lewipewi/bmi-270-board-v3/pcb/bmi270-board-v3.kicad_pcb

## KiCad design pcb/bmi270-board-v3.kicad_pcb (2026-10-18)

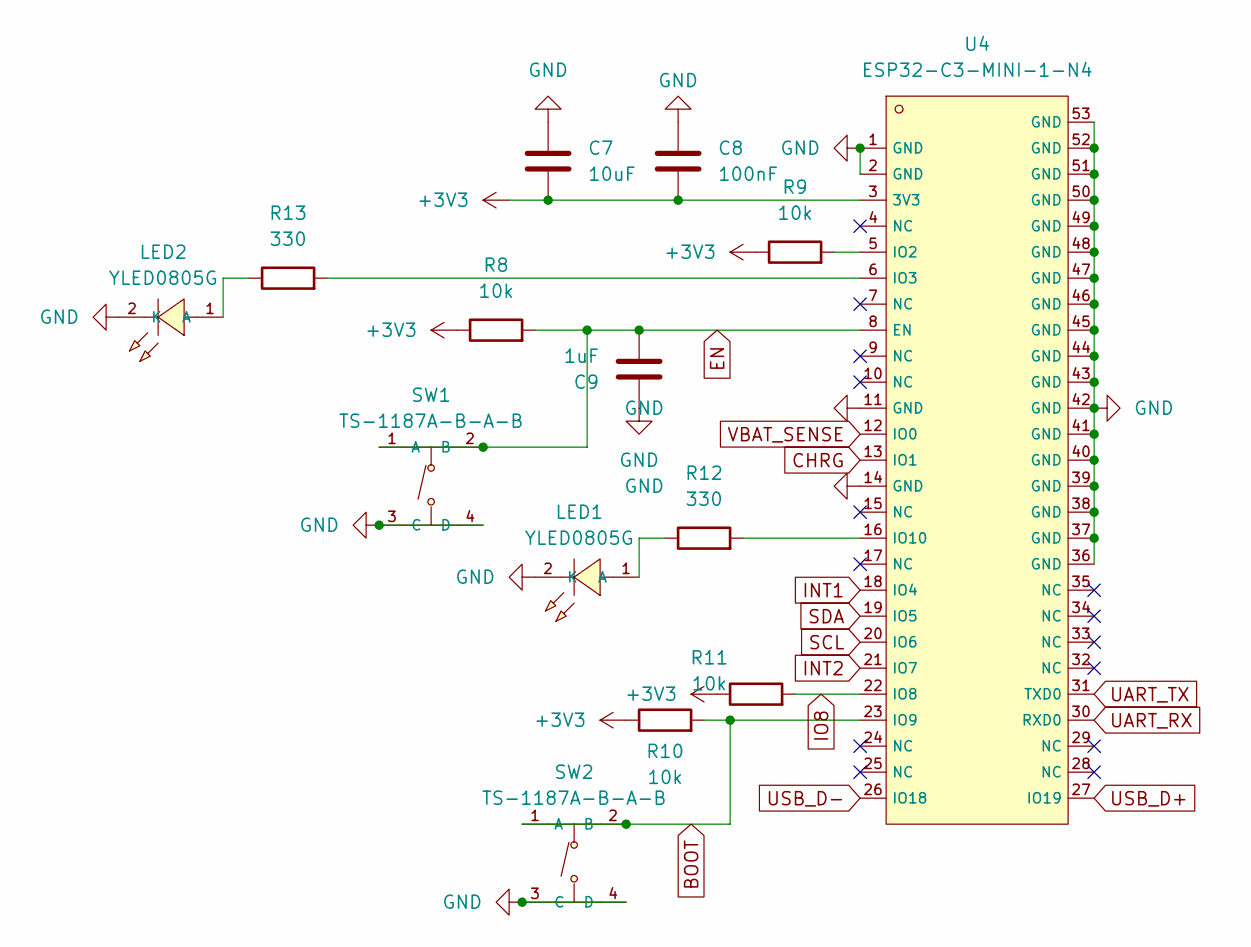
[picture p1: schematic mcu.kicad_sch]

Parts:
C7: 10uF; C_0805_2012Metric_Pad1.18x1.45mm_HandSolder
C8: 100nF; C_0603_1608Metric_Pad1.08x0.95mm_HandSolder
C9: 1uF; C_0603_1608Metric_Pad1.08x0.95mm_HandSolder
LED1, LED2: YLED0805G; C25170728_LED0805-FD-GREEN; LCSC C25170728
R8, R9, R10, R11: 10k; R_0603_1608Metric_Pad0.98x0.95mm_HandSolder
R12, R13: 330; R_0603_1608Metric_Pad0.98x0.95mm_HandSolder
SW1, SW2: TS-1187A-B-A-B; C318884_SW-SMD_4P-L5_1-W5_1-P3_70-LS6_5-TL_H1_5; LCSC C318884
U4: ESP32-C3-MINI-1-N4; C2838502_WIFIM-SMD_ESP32-C3-MINI-1; LCSC C2838502

Connections:
+3V3: C7.2, C8.2, R8.1, R9.1, R10.1, R11.1, U4.3 (3V3); also elsewhere on the board
BOOT: R10.2, SW2.1 (A), SW2.2 (B), U4.23 (IO9); also elsewhere on the board
CHRG: U4.13 (IO1); also elsewhere on the board
EN: C9.2, R8.2, SW1.1 (A), SW1.2 (B), U4.8 (EN); also elsewhere on the board
GND: C7.1, C8.1, C9.1, LED1.2 (K), LED2.2 (K), SW1.3 (C), SW1.4 (D), SW2.3 (C), SW2.4 (D), U4.1 (GND), U4.2 (GND), U4.11 (GND), U4.14 (GND), U4.36 (GND), U4.37 (GND), U4.38 (GND), U4.39 (GND), U4.40 (GND), U4.41 (GND), U4.42 (GND), U4.43 (GND), U4.44 (GND), U4.45 (GND), U4.46 (GND), U4.47 (GND), U4.48 (GND), U4.49 (GND), U4.50 (GND), U4.51 (GND), U4.52 (GND), U4.53 (GND); also elsewhere on the board
INT1: U4.18 (IO4); also elsewhere on the board
INT2: U4.21 (IO7); also elsewhere on the board
IO8: R11.2, U4.22 (IO8); also elsewhere on the board
unnamed: LED1.1 (A), R12.1
unnamed: LED2.1 (A), R13.1
unnamed: R9.2, U4.5 (IO2)
unnamed: R13.2, U4.6 (IO3)
unnamed: R12.2, U4.16 (IO10)
SCL: U4.20 (IO6); also elsewhere on the board
SDA: U4.19 (IO5); also elsewhere on the board
UART_RX: U4.30 (RXD0); also elsewhere on the board
UART_TX: U4.31 (TXD0); also elsewhere on the board
USB_D+: U4.27 (IO19); also elsewhere on the board
USB_D-: U4.26 (IO18); also elsewhere on the board
VBAT_SENSE: U4.12 (IO0); also elsewhere on the board

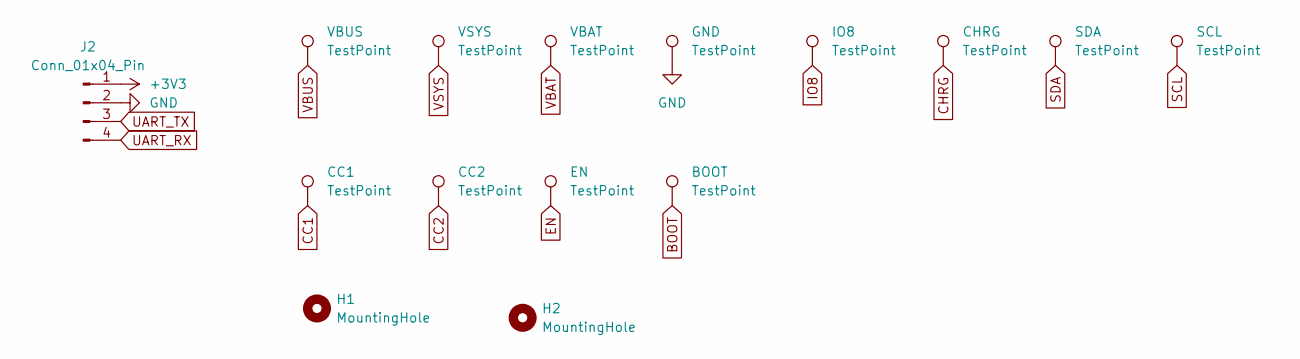
[picture p2: schematic MECHANICAL.kicad_sch]

Parts:
BOOT: TestPoint; TestPoint_Pad_D1.0mm
CC1, CC2: TestPoint; TestPoint_Pad_D1.0mm
CHRG: TestPoint; TestPoint_Pad_D1.0mm
EN: TestPoint; TestPoint_Pad_D1.0mm
GND: TestPoint; TestPoint_Pad_D1.0mm
H1, H2: MountingHole; MountingHole_2.2mm_M2
IO8: TestPoint; TestPoint_Pad_D1.0mm
J2: Conn_01x04_Pin; PinHeader_1x04_P2.54mm_Vertical
SCL: TestPoint; TestPoint_Pad_D1.0mm
SDA: TestPoint; TestPoint_Pad_D1.0mm
VBAT: TestPoint; TestPoint_Pad_D1.0mm
VBUS: TestPoint; TestPoint_Pad_D1.0mm
VSYS: TestPoint; TestPoint_Pad_D1.0mm

Connections:
+3V3: J2.1; also elsewhere on the board
BOOT: BOOT.1; also elsewhere on the board
CC1: CC1.1; also elsewhere on the board
CC2: CC2.1; also elsewhere on the board
CHRG: CHRG.1; also elsewhere on the board
EN: EN.1; also elsewhere on the board
GND: GND.1, J2.2; also elsewhere on the board
IO8: IO8.1; also elsewhere on the board
SCL: SCL.1; also elsewhere on the board
SDA: SDA.1; also elsewhere on the board
UART_RX: J2.4; also elsewhere on the board
UART_TX: J2.3; also elsewhere on the board
VBAT: VBAT.1; also elsewhere on the board
VBUS: VBUS.1; also elsewhere on the board
VSYS: VSYS.1; also elsewhere on the board

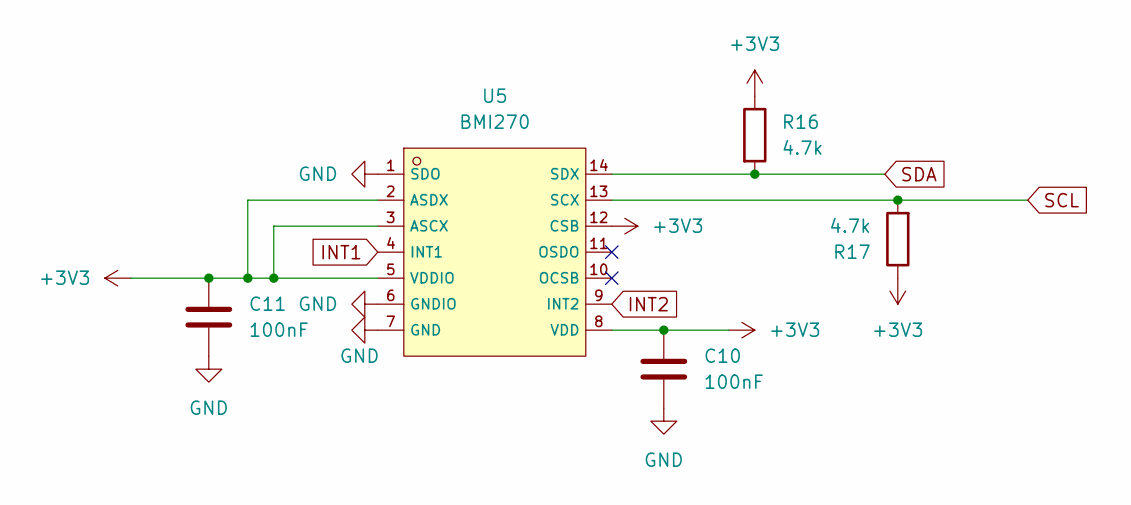
[picture p3: schematic IMU.kicad_sch]

Parts:
C10, C11: 100nF; C_0603_1608Metric_Pad1.08x0.95mm_HandSolder
R16, R17: 4.7k; R_0603_1608Metric_Pad0.98x0.95mm_HandSolder
U5: BMI270; C2836813_LGA-14_L3_0-W2_5-P0_50-BR; LCSC C2836813

Connections:
+3V3: C10.1, C11.1, R16.1, R17.1, U5.2 (ASDX), U5.3 (ASCX), U5.5 (VDDIO), U5.8 (VDD), U5.12 (CSB); also elsewhere on the board
GND: C10.2, C11.2, U5.1 (SDO), U5.6 (GNDIO), U5.7 (GND); also elsewhere on the board
INT1: U5.4 (INT1); also elsewhere on the board
INT2: U5.9 (INT2); also elsewhere on the board
SCL: R17.2, U5.13 (SCX); also elsewhere on the board
SDA: R16.2, U5.14 (SDX); also elsewhere on the board

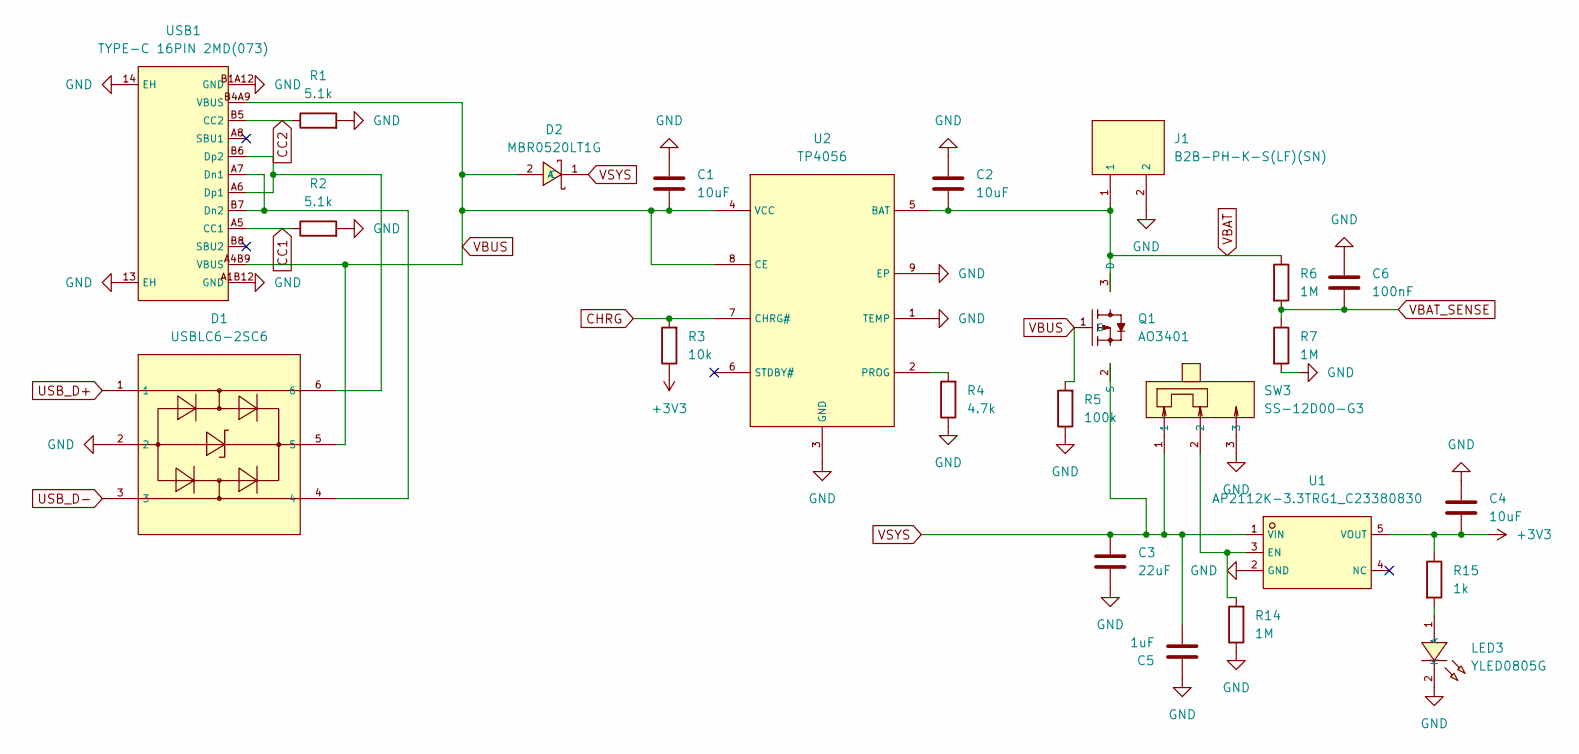
[picture p4: schematic power.kicad_sch]

Parts:
C1, C2, C4: 10uF; C_0805_2012Metric_Pad1.18x1.45mm_HandSolder
C3: 22uF; C_1206_3216Metric_Pad1.33x1.80mm_HandSolder
C5: 1uF; C_0603_1608Metric_Pad1.08x0.95mm_HandSolder
C6: 100nF; C_0603_1608Metric_Pad1.08x0.95mm_HandSolder
D1: USBLC6-2SC6; C7519_SOT-23-6_L2_9-W1_6-P0_95-LS2_8-BL; LCSC C7519
D2: MBR0520LT1G; C23848_SOD-123_L2_8-W1_8-LS3_7-RD; LCSC C23848
J1: B2B-PH-K-S(LF)(SN); C131337_CONN-TH_B2B-PH-K-S; LCSC C131337
LED3: YLED0805G; C25170728_LED0805-FD-GREEN; LCSC C25170728
Q1: AO3401; C181091_SOT-23-3_L2_9-W1_3-P1_90-LS2_4-BR; LCSC C181091
R1, R2: 5.1k; R_0603_1608Metric_Pad0.98x0.95mm_HandSolder
R3: 10k; R_0603_1608Metric_Pad0.98x0.95mm_HandSolder
R4: 4.7k; R_0603_1608Metric_Pad0.98x0.95mm_HandSolder
R5: 100k; R_0603_1608Metric_Pad0.98x0.95mm_HandSolder
R6, R7, R14: 1M; R_0603_1608Metric_Pad0.98x0.95mm_HandSolder
R15: 1k; R_0603_1608Metric_Pad0.98x0.95mm_HandSolder
SW3: SS-12D00-G3; C22355741_SW-TH_3P-L8_8-W3_9-P2_50_SS12D00G3; LCSC C22355741
U1: AP2112K-3.3TRG1_C23380830; C23380830_SOT-23-5_L2_9-W1_6-P0_95-LS2_8-BR; LCSC C23380830
U2: TP4056; C16581_ESOP-8_L4_9-W3_9-P1_27-LS6_0-BL-EP; LCSC C16581
USB1: TYPE-C 16PIN 2MD(073); C2765186_USB-C-SMD_TYPE-C-16PIN-2MD-073; LCSC C2765186

Connections:
+3V3: C4.2, R3.1, R15.1, U1.5 (VOUT); also elsewhere on the board
CC1: R2.1, USB1.A5 (CC1); also elsewhere on the board
CC2: R1.1, USB1.B5 (CC2); also elsewhere on the board
CHRG: R3.2, U2.7 (CHRG#); also elsewhere on the board
GND: C1.1, C2.1, C3.2, C4.1, C5.1, C6.1, D1.2, J1.2, LED3.2 (K), R1.2, R2.2, R4.1, R5.1, R7.2, R14.1, SW3.3, U1.2 (GND), U2.1 (TEMP), U2.3 (GND), U2.9 (EP), USB1.13 (EH), USB1.14 (EH), USB1.A1B12 (GND), USB1.B1A12 (GND); also elsewhere on the board
unnamed: LED3.1 (A), R15.2
unnamed: R14.2, SW3.2, U1.3 (EN)
unnamed: R4.2, U2.2 (PROG)
unnamed: D1.4, USB1.A7 (Dn1), USB1.B7 (Dn2)
unnamed: D1.6, USB1.A6 (Dp1), USB1.B6 (Dp2)
USB_D+: D1.1; also elsewhere on the board
USB_D-: D1.3; also elsewhere on the board
VBAT: C2.2, J1.1, Q1.3 (D), R6.1, U2.5 (BAT); also elsewhere on the board
VBAT_SENSE: C6.2, R6.2, R7.1; also elsewhere on the board
VBUS: C1.2, D1.5, D2.2 (A), Q1.1 (G), R5.2, U2.4 (VCC), U2.8 (CE), USB1.A4B9 (VBUS), USB1.B4A9 (VBUS); also elsewhere on the board
VSYS: C3.1, C5.2, D2.1 (C), Q1.2 (S), SW3.1, U1.1 (VIN); also elsewhere on the board

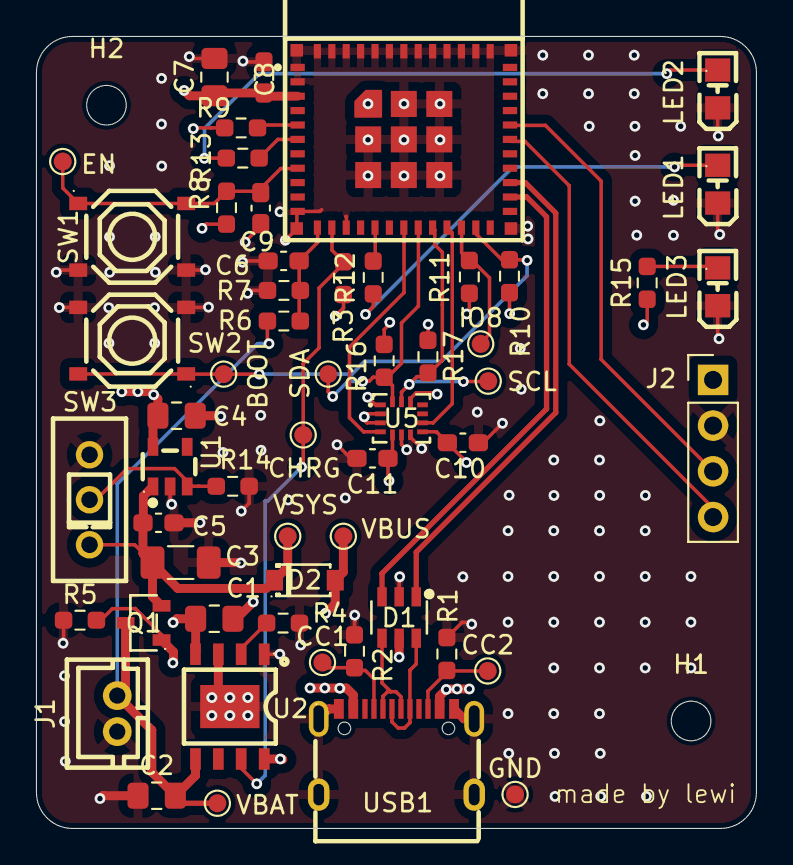
[picture p5: board bmi270-board-v3.kicad_pcb from above]

Board: 4 copper layers, 40.0 x 44.0 mm, 58 parts (0 on the bottom side), 30 nets.
